vbookshelf/BasicBot-Experiments/Exp_02-basics-of-robot-movement/README.md

## Exp_02 - Basics of Robot Movement

<br>

<br>
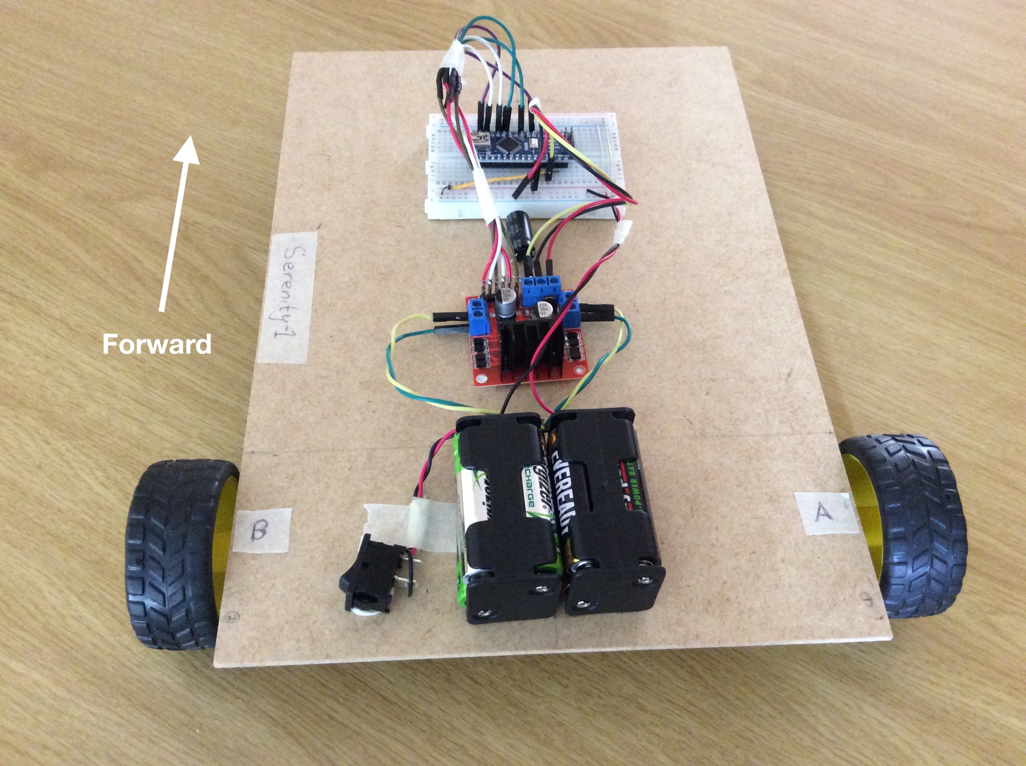
[picture p7: images/movement.jpg]

<br>

### Objective

Learn how to make the robot execute different movements.

### Summary

Please refer the the attached pdf file: Serenity-1-Movement-Basics.pdf

### Lessons Learned

- Increasing the voltage increases the motor speed.<br>

- When movement sequences are hard coded, they are not executed exactly the same way each time. This is due to variations in the surface under the wheels, reduction in motor voltage over time and other factors. Instead of hard coding, some kind of feedback mechanism is needed to ensure that the robot always moves in a predictable way.

<br>

## Reference Resources

Digital Electronics: Robotics, learn by building module II<br>
Lesson 44 - Using PWM and an H-bridge<br>
https://www.udemy.com/course/digital-electronics-robotics-learn-by-building-module-ii/learn/lecture/7031128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<br>

Digital Electronics: Robotics, learn by building module II<br>
Lesson 60 - Programming and calibrating movements on our mobile robot<br>
https://www.udemy.com/course/digital-electronics-robotics-learn-by-building-module-ii/learn/lecture/13524884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<br>

<br>
