vbookshelf/BasicBot-Experiments/LCD-1602/lcd-wirind-diagram.pdf

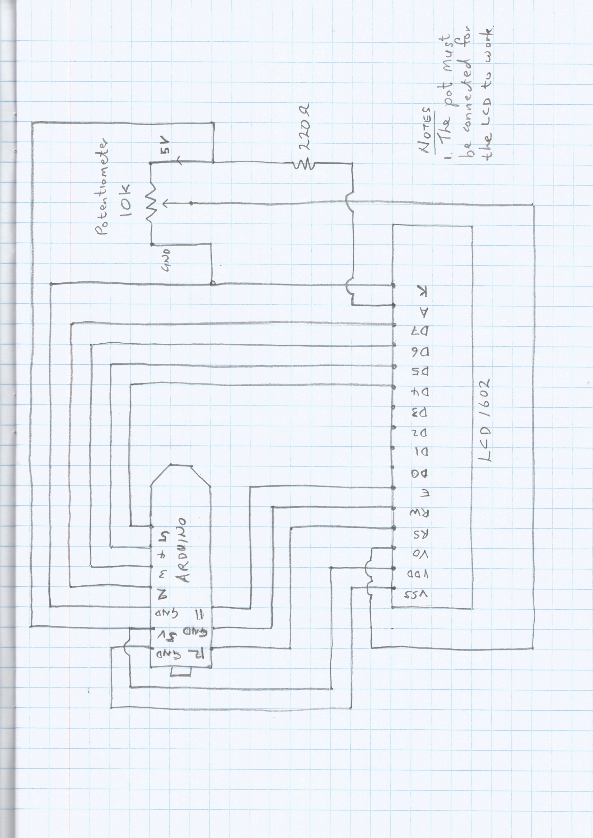
[picture p13: page 1]
