vbookshelf/BasicBot-Experiments/Exp_05-computer-vision-control-raspberry_pi-arduino/exp05-wiring-diagram.pdf

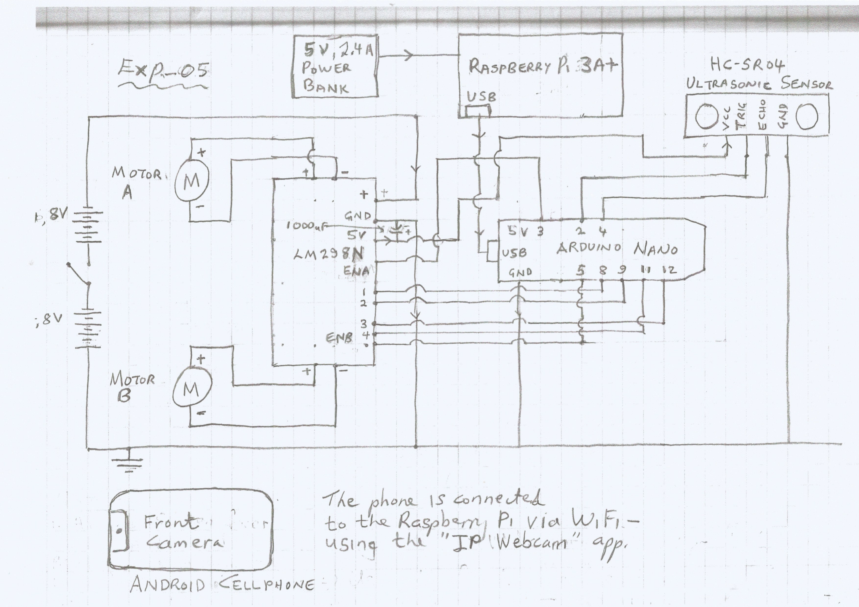
[picture p14: page 1]
