vbookshelf/BasicBot-Experiments/exp_04-raspberry_pi-arduino-remote-control/exp04-wiring-diagram.pdf

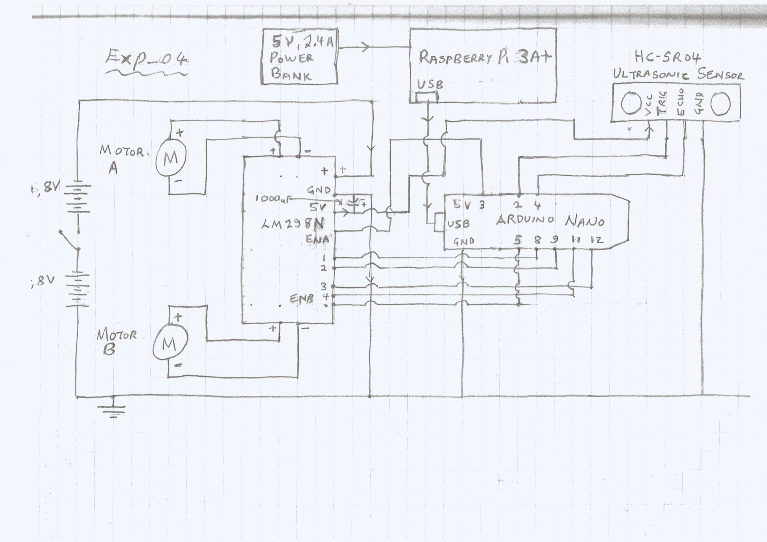
[picture p15: page 1]
