vbookshelf/BasicBot-Experiments/Exp_03-ultrasonic-distance-sensor/exp03-wiring-diagram.pdf

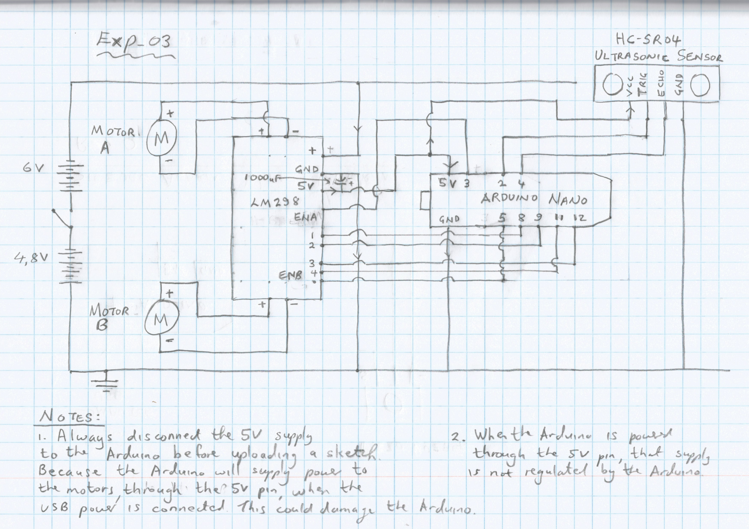
[picture p16: page 1]
