vbookshelf/BasicBot-Experiments/Exp_02-basics-of-robot-movement/exp02-wiring-diagram.pdf

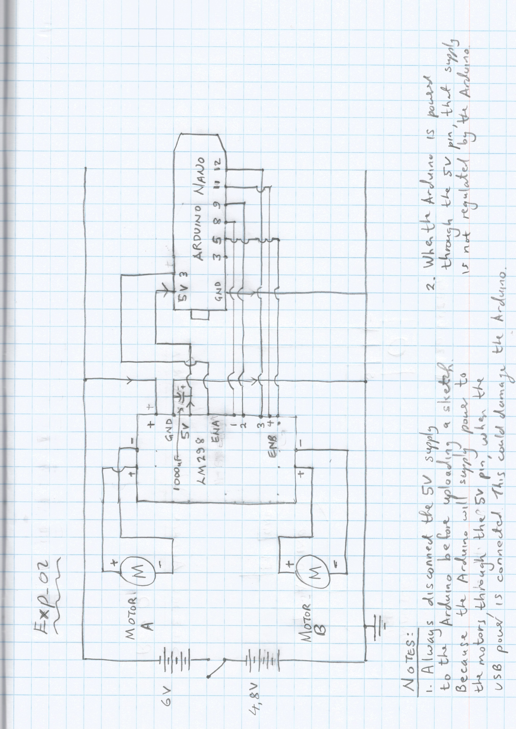
[picture p17: page 1]
