vbookshelf/BasicBot-Experiments/Exp01-move-forward-in-a-straight-line/exp01-wiring-diagram.pdf

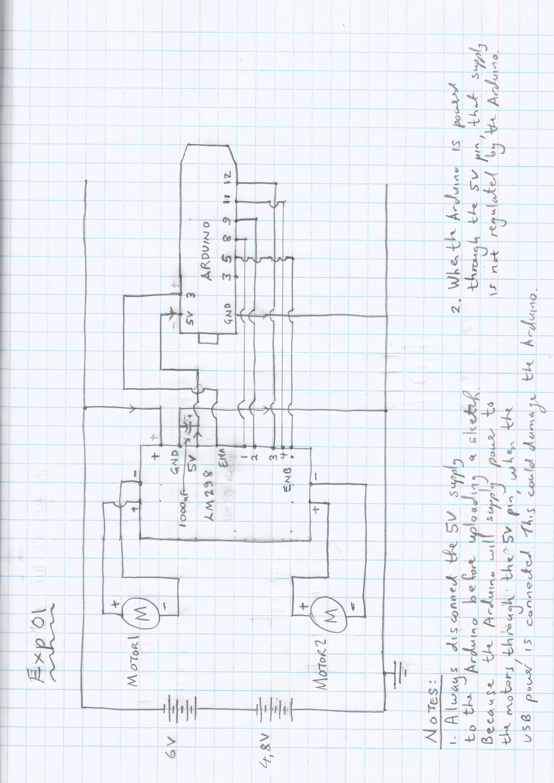
[picture p18: page 1]
