vbookshelf/BasicBot-Experiments/Exp_05-computer-vision-control-raspberry_pi-arduino/exp05-arduino-sketch/exp05-arduino-sketch.ino

// Motor A
#define enaPin 3
#define in1Pin 8
#define in2Pin 9


// Motor B
#define enbPin 5
#define in3Pin 11
#define in4Pin 12

// HC-SR04 Ultrasonic sensor
// Requires a 5V input.
#define echoPin 4
#define trigPin 2


float duration, distance;
String key_status;



///////// Helper Functions ////////////

float get_distance() {

  /*
   * This function returns the distance measured by
   * the ultrasonic sensor.
   * 
   * Output:
   *  distance in cm, type: float
   */

  float distance;

  // Start with everything off
  digitalWrite(trigPin, LOW);
  delayMicroseconds(2);

  digitalWrite(trigPin, HIGH);
  delayMicroseconds(10);
  digitalWrite(trigPin, LOW);

  // Mesaure the response from the Echo Pin

  duration = pulseIn(echoPin, HIGH);

  // Use the duration to determine the distance
  // Use 343 m/s as the speed of sound
  // the signal from the trig pin goes out then returns, thats why we divide the duration by 2.
  distance = (duration / 2) * 0.0343;

  return distance;
  
}

void stand_still() {

  // Full stop 
  analogWrite(enaPin, 0);
  analogWrite(enbPin, 0);
  
}

void move_forward() {

  // B|-------|A

  // To get the same speed on both motors
  // these are the PWM values:
  // Motor A: 128
  // Motor B: 190 

  // Motor B is ON.
  // Motor A is ON.

  // Full stop before changing motor direction
  analogWrite(enaPin, 0);
  analogWrite(enbPin, 0);

  // 1- Set the direction of rotation

  // Motor A - rotating forwards
  digitalWrite(in1Pin, HIGH);
  digitalWrite(in2Pin, LOW);

  // Motor B - rotating forwards
  digitalWrite(in3Pin, LOW);
  digitalWrite(in4Pin, HIGH);
  

  // 2- Start the motors and set their speed
  
  analogWrite(enaPin, 128.55); // speed set to 0
  analogWrite(enbPin, 190);
  
}

void reverse() {

  // B|-------|A

  // To get the same speed on both motors
  // these are the PWM values:
  // Motor A: 128
  // Motor B: 190 

  // Motor B is ON.
  // Motor A is ON.

  // Full stop before changing motor direction
  analogWrite(enaPin, 0);
  analogWrite(enbPin, 0);

  // 1- Set the direction of rotation

  // Motor A - rotating backwards
  digitalWrite(in1Pin, LOW);
  digitalWrite(in2Pin, HIGH);

  // Motor B - rotating backwards
  digitalWrite(in3Pin, HIGH);
  digitalWrite(in4Pin, LOW);
  

  // 2- Start the motors and set their speed
  
  analogWrite(enaPin, 128); // speed set to 0
  analogWrite(enbPin, 190);
  
}


void reverse_slowly() {

  // B|-------|A

  // To get almost the same speed on both motors
  // these are some PWM values:
  // (Range is 0-255)
  // Motor A: 128,  64
  // Motor B: 190,  95
  

  // Motor B is ON.
  // Motor A is ON.

  // Full stop before changing motor direction
  analogWrite(enaPin, 0);
  analogWrite(enbPin, 0);

  // 1- Set the direction of rotation

  // Motor A - rotating backwards
  digitalWrite(in1Pin, LOW);
  digitalWrite(in2Pin, HIGH);

  // Motor B - rotating backwards
  digitalWrite(in3Pin, HIGH);
  digitalWrite(in4Pin, LOW);
  

  // 2- Start the motors and set their speed
  
  analogWrite(enaPin, 64); // speed set to 0
  analogWrite(enbPin, 95);
  
}





void turn_left() {

  // B|-------|A


  // Motor B is ON.
  // Motor A is OFF.
  // Therefore, the pivot point is Wheel A.

  // Full stop before changing motor direction
  analogWrite(enaPin, 0);
  analogWrite(enbPin, 0);

  // 1- Set the direction of rotation

  // Motor A - stopped
  digitalWrite(in1Pin, LOW);
  digitalWrite(in2Pin, LOW);

  // Motor B - rotating backwards
  digitalWrite(in3Pin, HIGH);
  digitalWrite(in4Pin, LOW);
  

  // 2- Start the motors and set their speed
 
  analogWrite(enaPin, 0); // Motor A - speed set to 0
  analogWrite(enbPin, 128);
  
}


void turn_right() {

  // The delay needed for the robot to turn 360 degrees
  // is approx. 6000ms. This varies depending on the surface.

  // Motor A is OFF.
  // Motor B is ON.
  // Therefore, the pivot point is Wheel A.

  // Full stop before changing motor direction
  analogWrite(enaPin, 0);
  analogWrite(enbPin, 0);

  // 1- Set the direction of rotation

  // Motor A - stopped
  digitalWrite(in1Pin, LOW);
  digitalWrite(in2Pin, LOW);

  // Motor B - rotating forwards
  digitalWrite(in3Pin, LOW);
  digitalWrite(in4Pin, HIGH);
  

  // 2- Start the motors and set their speed
  
  analogWrite(enaPin, 0); // Motor A speed set to 0
  analogWrite(enbPin, 128);
  
}


void rotate_left() {

  // B|-------|A


  // Motor B is ON, moving backwards.
  // Motor A is ON, moving forwards.
  // The pivot point is half way between Wheel A and Wheel B.

  // Full stop before changing motor direction
  analogWrite(enaPin, 0);
  analogWrite(enbPin, 0);

  // 1- Set the direction of rotation

  // Motor A - rotating forwards
  digitalWrite(in1Pin, HIGH);
  digitalWrite(in2Pin, LOW);

  // Motor B - rotating backwards
  digitalWrite(in3Pin, HIGH);
  digitalWrite(in4Pin, LOW);
  

  // 2- Start the motors and set their speed
 
  analogWrite(enaPin, 128); 
  analogWrite(enbPin, 128);
  
}


///////////// End of helper functions ////////////////




void setup() {

  Serial.begin(9600);

  // define the pin modes
  
  pinMode(enaPin, OUTPUT);
  pinMode(in1Pin, OUTPUT); 
  pinMode(in2Pin, OUTPUT); 

  pinMode(enbPin, OUTPUT);
  pinMode(in3Pin, OUTPUT); 
  pinMode(in4Pin, OUTPUT); 
  
 
  pinMode(trigPin, OUTPUT);
  pinMode(echoPin, INPUT);
  
  
}

void loop() {


    // [1] Get the distance measured by the ultrasonic sensor
    // We won't be using the distance in this code.
    distance = get_distance();
  
    // *** Remember that the serial monitor must be closed when
    // sending info from the python code.
    Serial.println(distance);
  
    // [2] Read the key status sent by the python code (up, down, left, right or key-up).
    // Store it in a variable called "key_status".
     
    // This line means: "read until you reach a newline chracter".
    // You will see that in the python code we have added a newline character before sending the string.
    key_status = Serial.readStringUntil('\n');
  
    // Remove any leading and trailing whitespaces that could have been added.
    // Sometimes when devices are communicating they add a whitespace.
    key_status.trim();


    // if the user is holding up 3 fingers
    if (key_status.equals("one")) {
  
        move_forward();

    // if the user is holding up 4 fingers 
    } else if (key_status.equals("two")) {
      
        reverse_slowly();
  
    } else {

      stand_still();
      
    }

  
}
